bigbearishappy/BBear_balance_car/PCB_MCU/Balance_car_PCB_v4.0_summary.txt

第三版PCB存在的问题：
1 红外遥控接收管的引脚接错
2 电机升压芯片驱动能力不够，需要更换芯片
3 电池接口容易插反
4 没有引出拓展接口
5 串口的vcc脚电压太高了，改为3.3v

第四版需要改进的地方：
1 红外遥控接收管引脚接对 OK
2 去除MCU板上的升压电路 OK
3 将串口的vcc修改为3.3v OK
4 贴片排针注意修改好相关引线 OK
5 给红外接收器加上拉电阻 OK
