bigbearishappy/BBear_balance_car/PCB_MCU/Balance_car_PCB_v2.0_summary.txt

对于上一版问题的解决：
1 对于电阻值的选择没有确定好 OK
2 电机驱动设计前没有验证 OK
3 尽可能采用驱动芯片 OK
4 LED放置位置有问题 OK

第二版存在的问题：
1 电源正负极标反
2 电机驱动模块的定位不准
3 电机放置的位置没有画出来
4 没有总开关

下一版需要修改的地方：
1 电源正负极标对 OK
2 电机驱动模块定位修改好 OK
3 电机放置位置丝印 OK
4 添加总开关  OK
5 蓝牙模块放置于板子中部 OK
6 复位开关换位贴片的  OK
7 boot1,2去掉没有用的那个(去掉boot1,直接接地) OK
8 电机放置时位置往外移动2mm not OK
