bigbearishappy/BBear_balance_car/PCB_MCU/Balance_car_PCB_v1.0_summary.txt

1 对于电阻值的选择没有确定好
2 电机驱动设计前没有验证
3 尽可能采用驱动芯片
4 LED放置位置有问题
