bigbearishappy/BBear_balance_car/PCB_MCU/Balance_car_PCB_v5.0_summary.txt

第四版存在的问题：
1 MPU6050固定效果不好
2 升压电路没有受到总开关控制
3 红外接收器容易接触不良
4 电源拓展接口太少

第五版需要改进的地方：
1 给MPU6050添加铜立柱进行固定 OK
2 升压电路必须收总开关控制 OK
3 红外接收器接口换新接口 OK
4 添加两个3.3v拓展接口及两个GND接口 OK
