bigbearishappy/BBear_balance_car/doc/car_picture/BBear_balancecar1.jpg

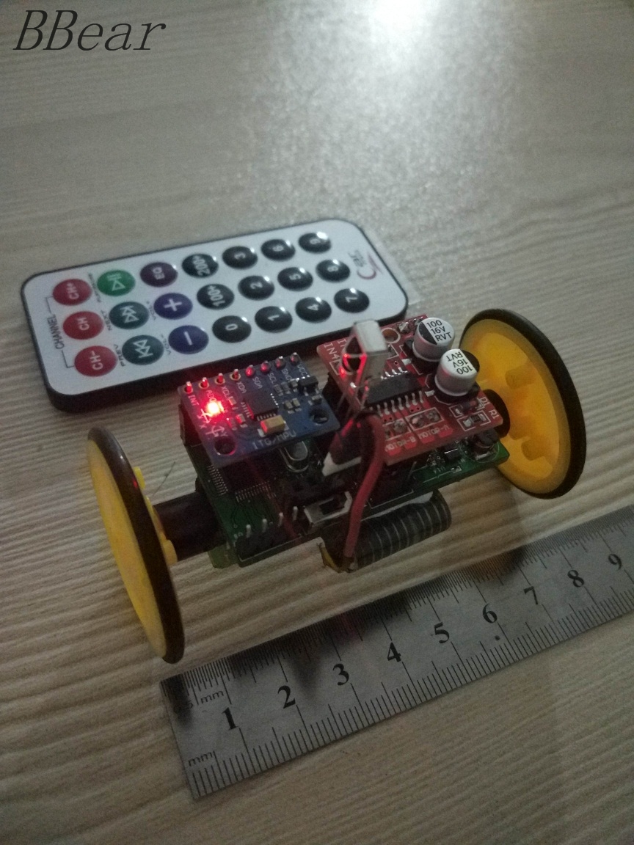
doc/car_picture/BBear_balancecar1.jpg
