bigbearishappy/BBear_balance_car/doc/car_picture/BBear_balancecar4.jpg

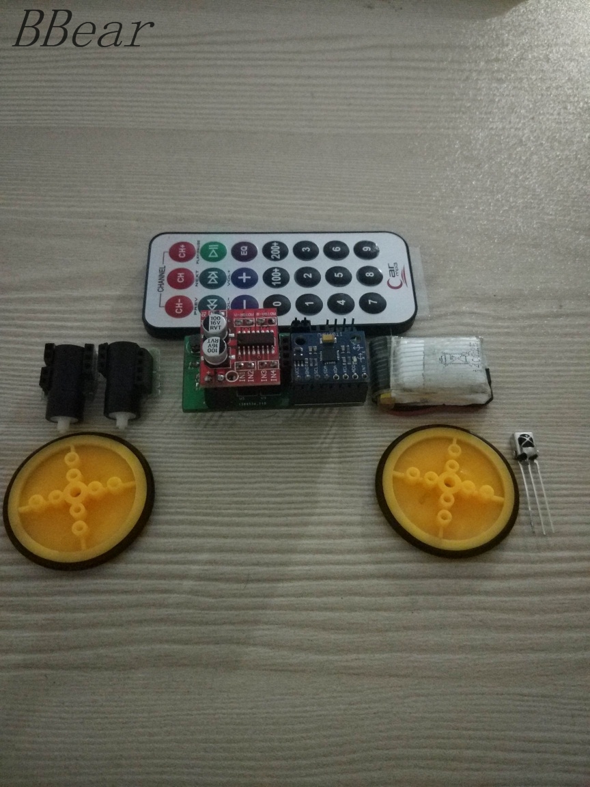
doc/car_picture/BBear_balancecar4.jpg
