bigbearishappy/BBear_balance_car/doc/car_picture/BBear_balancecar7.jpg

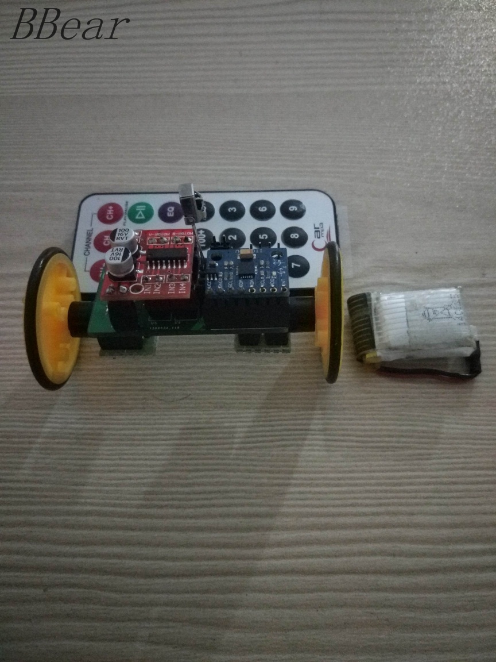
doc/car_picture/BBear_balancecar7.jpg
