bigbearishappy/BBear_balance_car/doc/experience/xtal_unusual_pic.jpg

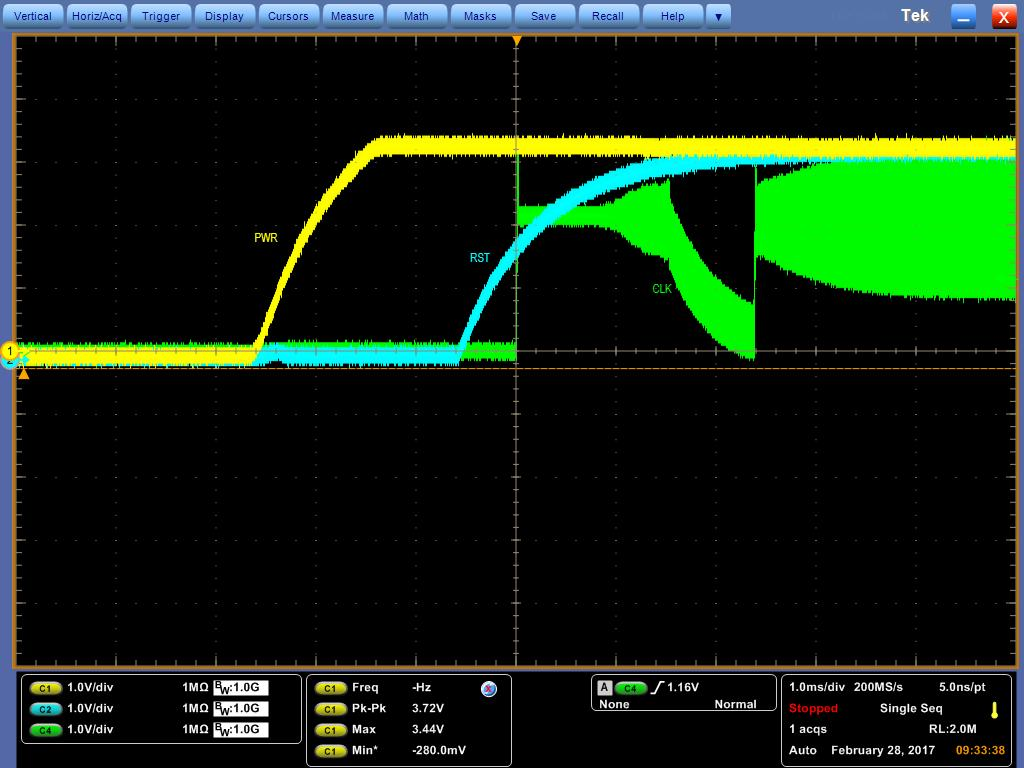
doc/experience/xtal_unusual_pic.jpg
