bigbearishappy/BBear_balance_car/doc/experience/xtal_usual_pic.jpg

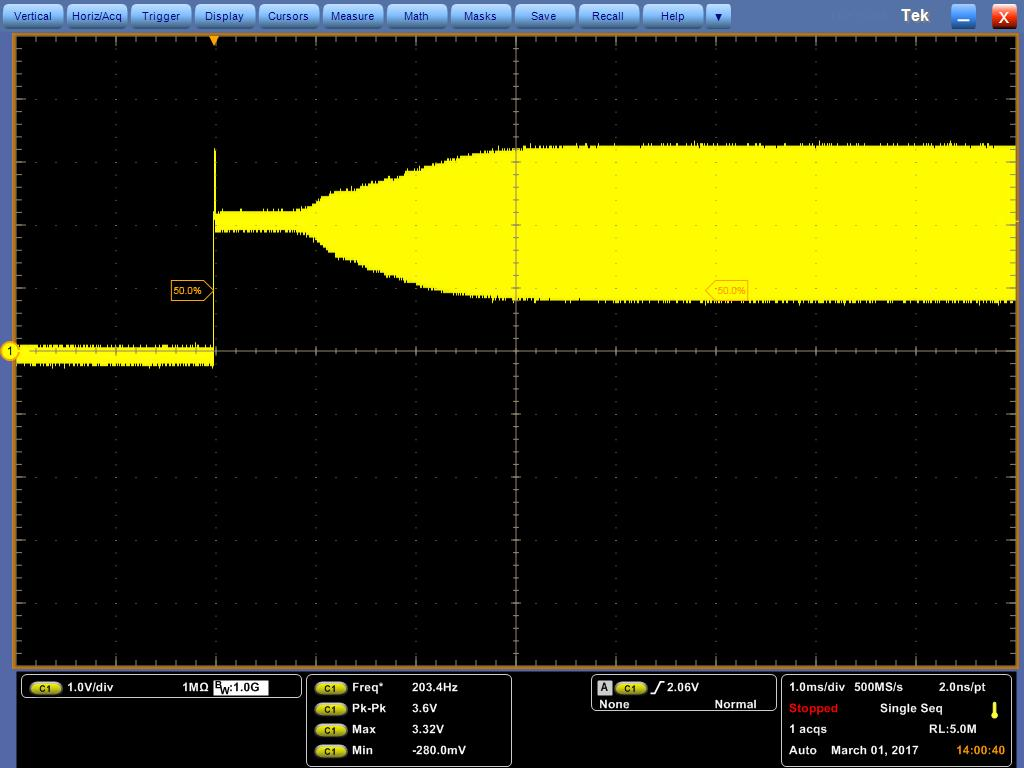
doc/experience/xtal_usual_pic.jpg
