bigbearishappy/BBear_balance_car/PCB_MCU/schematic/8cb1cb13495409232dfafa0c9758d109b3de4935.jpg

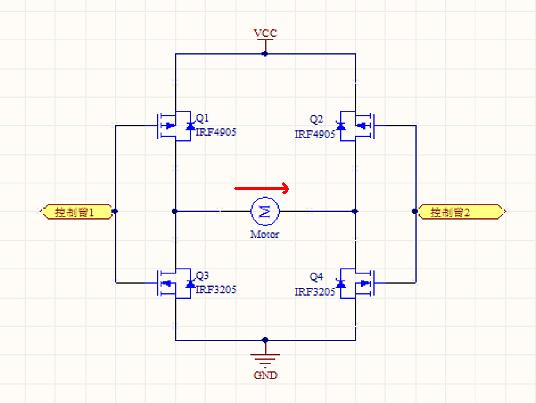
PCB_MCU/schematic/8cb1cb13495409232dfafa0c9758d109b3de4935.jpg
