bigbearishappy/BBear_balance_car/PCB_SPEED/doc/refered_schematic.PNG

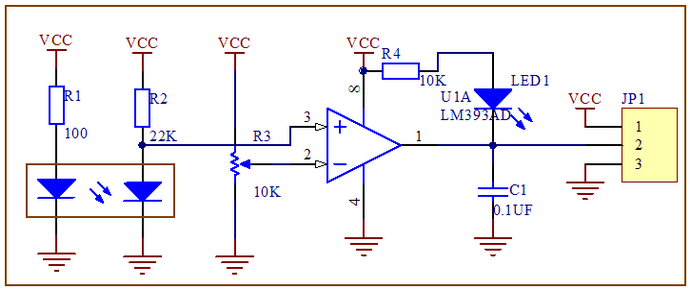
PCB_SPEED/doc/refered_schematic.PNG
