bigbearishappy/BBear_balance_car/(list of files, cad)

Other CAD files:
PCB_MCU/pcb_lib/3_6key.psm
PCB_MCU/pcb_lib/button_6x6x5.psm
PCB_MCU/pcb_lib/c-0603.psm
PCB_MCU/pcb_lib/cd43.psm
PCB_MCU/pcb_lib/con2_r2_54.psm
PCB_MCU/pcb_lib/con3.psm
PCB_MCU/pcb_lib/con4.psm
PCB_MCU/pcb_lib/con8.psm
PCB_MCU/pcb_lib/lm1117_3_3.psm
PCB_MCU/pcb_lib/ncu100_lqfp_48.psm
PCB_MCU/pcb_lib/p4_003_20.psm
PCB_MCU/pcb_lib/sod-123.psm
PCB_MCU/pcb_lib/sot-89.psm
PCB_MCU/pcb_lib/sot223.psm
PCB_MCU/pcb_lib/tp2_54_5.psm
PCB_MCU/pcb_lib/xc9119.psm
PCB_MCU/pcb_lib/xtal.psm
PCB_MOTOR/PCB_lib/1n5819.psm
PCB_MOTOR/PCB_lib/c-0805.psm
PCB_MOTOR/PCB_lib/cdrh104r.psm
PCB_MOTOR/PCB_lib/con5.psm
PCB_MOTOR/PCB_lib/sdb628.psm
PCB_SPEED/pcb_lib/con2_3mm.psm
PCB_SPEED/pcb_lib/con2_3mm_t.psm
PCB_SPEED/pcb_lib/so8.psm
