bigbearishappy/BBear_balance_car/PCB_MCU/bbear_balance_car.pdf

5

4

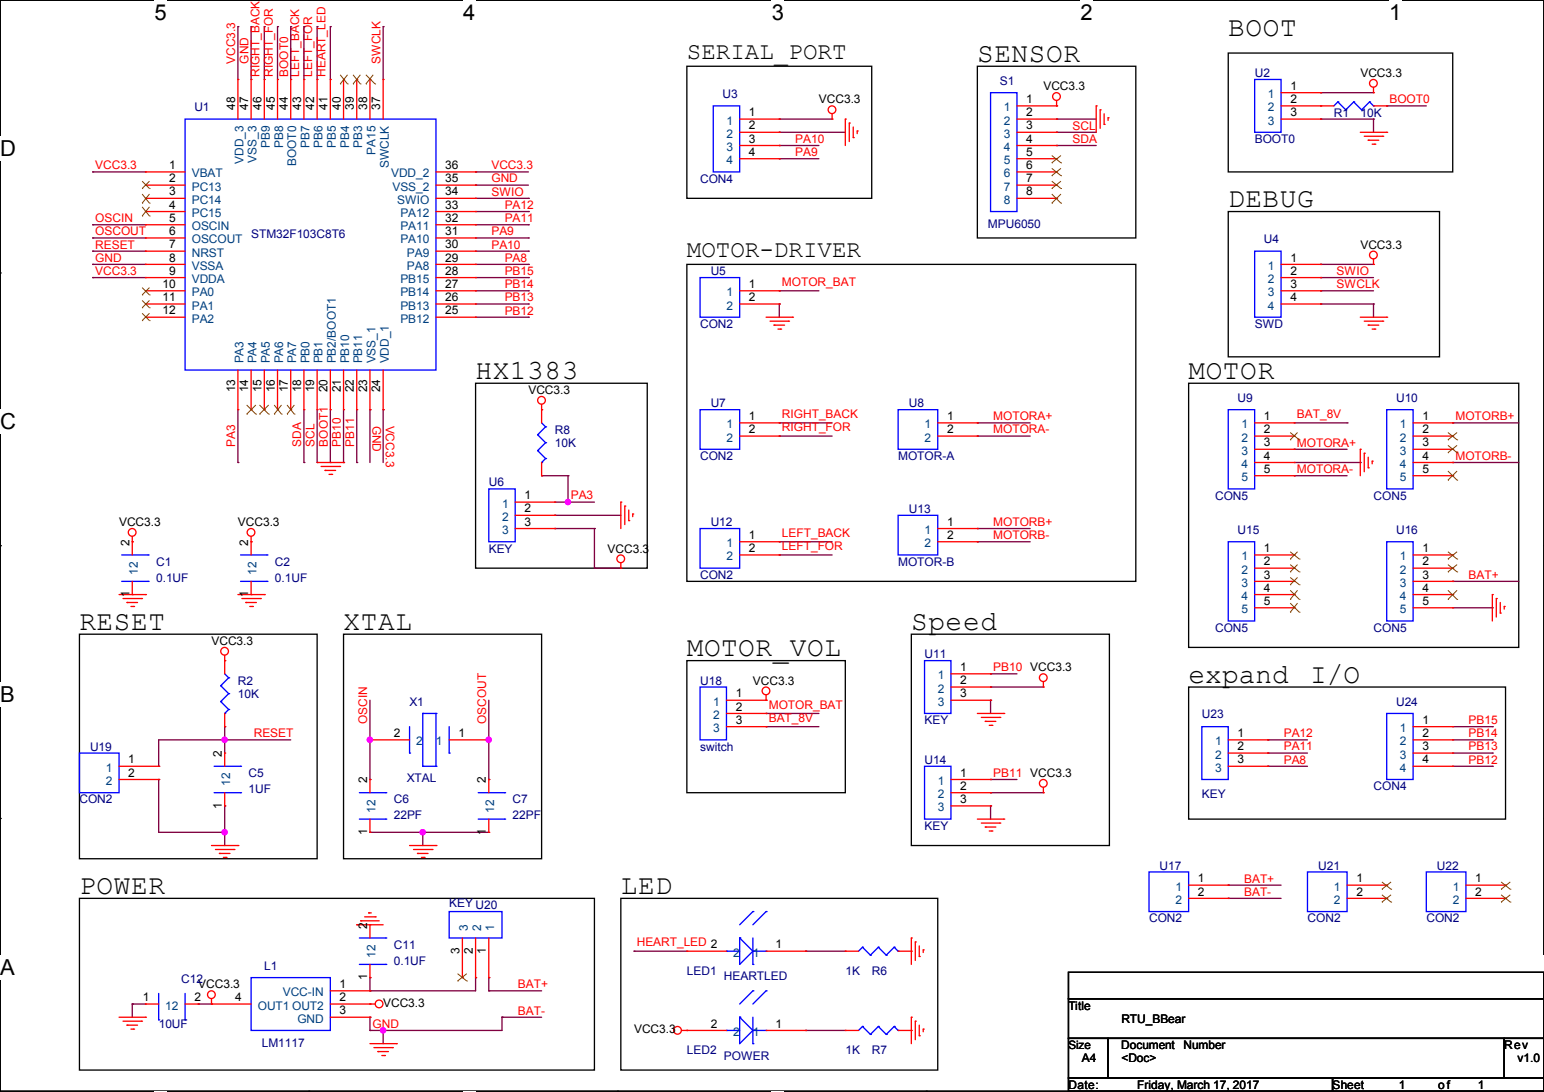
[picture p26: page 1]
