bigbearishappy/BBear_balance_car/PCB_MOTOR/bbear_balance_car_motor.pdf

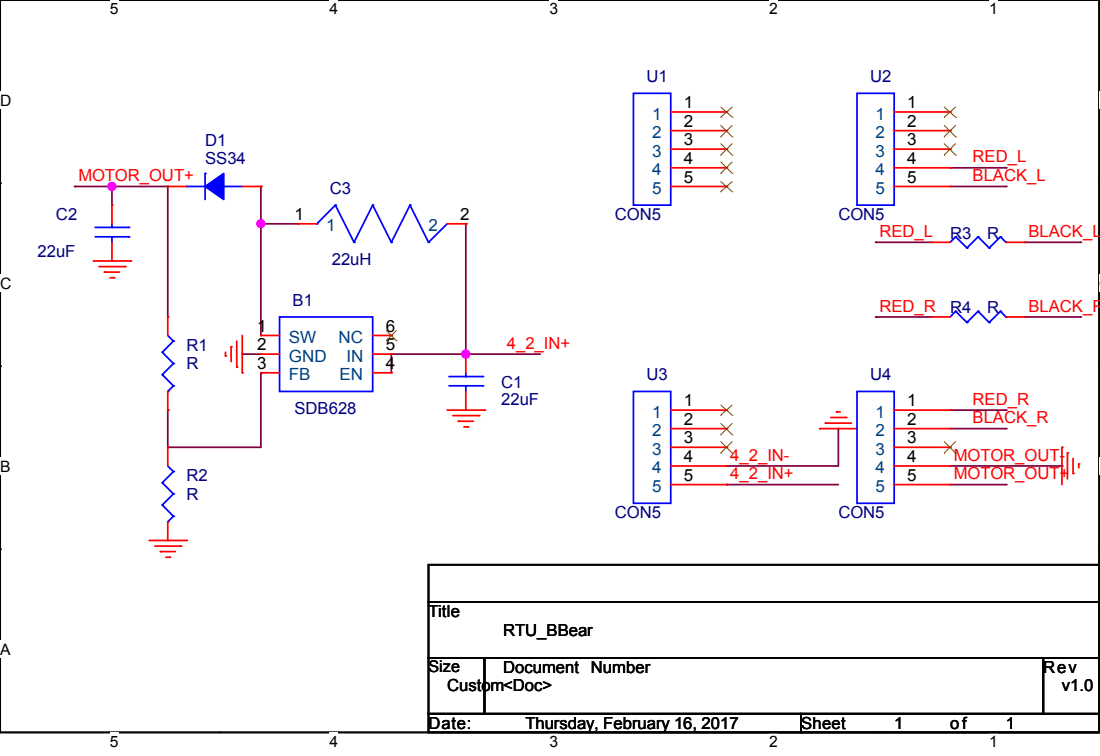
[picture p27: page 1]
