bigbearishappy/BBear_balance_car/(list of files, drawings)

Other design files:
PCB_MCU/schematic/BBEAR_BALANCE_CAR.DSN
PCB_MCU/schematic/BBear_balance_car.opj
PCB_MCU/schematic/DESIGN1.DSN
PCB_MCU/schematic/Design1.opj
PCB_MCU/schematic/f1.opj
PCB_MCU/schematic_lib/LIBRARY1.OLB
PCB_MCU/schematic_lib/library1.opj
PCB_MOTOR/schematic/BBEAR_BALANCE_CAR_MOTOR.DSN
PCB_MOTOR/schematic/BBear_balance_car_motor.opj
PCB_MOTOR/schematic_lib/LIBRARY1.OLB
PCB_MOTOR/schematic_lib/library1.opj
PCB_SPEED/schematic/SPEED_SENSOR.DSN
PCB_SPEED/schematic/Speed_sensor.opj
