bigbearishappy/BBear_balance_car/sourcecode/source_code/APP/pid.h

#ifndef PID_H
#define PID_H
#include<stdint.h>
#include"printf.h"
//#include "BSP.H"

#define LEFT_WHEEL	0x4c//'L' 's ascii code is 0x4c
#define RIGHT_WHEEL	0x52//'R' 's ascii code is 0x52

#define ADD_VALUE_LR	0.3
#define ADD_VALUE_FB	0.05//1

typedef struct PID
{
	float target;
	float integral;
	float Kp;	// 比例系数
	float Ki;	// 积分系数
	float Kd;	// 微分系数/Derivative
}pid_s, *pid_t;

void PID_Init(pid_t pid, float Kp, float Ki, float Kd);
int32_t PID_Cal_Ang(pid_s *p, float current, float differential, int target);
int32_t PID_Cal_Speed(pid_s *p, int32_t current, int32_t target,unsigned char which_wheel);

#endif
