bigbearishappy/BBear_balance_car/(commit log)

2016-10-05 create the catalog of the whole project doc:all the document of the project PCB:all the document of the PCB work source_code:all the source code of the project
2016-10-05 add the catalog of PCB
2016-10-05 create the schematic of project
    [BBEAR_BALANCE_CAR.DSN, BBear_balance_car.opj, DESIGN1.DSN, Design1.opj, LIBRARY1.OLB, f1.opj]
2016-10-06 draw the schematic library
    [BBear_balance_car.opj, LIBRARY1.OLB]
2016-10-07 draw the schematic and the PCB library files
    [BBEAR_BALANCE_CAR.DSN, BBear_balance_car.opj, LIBRARY1.OLB, button_6x6x5.psm, c-0603.psm, c-0805.psm, cases.cfg, con2_r2_54.psm]
2016-10-11 work out the netlist and import it into the board files
    [BBEAR_BALANCE_CAR.DSN, BBear_balance_car.brd, BBear_balance_car.opj, LIBRARY1.OLB, sot223.psm]
2016-10-12 work out the PCB layout
    [BBEAR_BALANCE_CAR.DSN, BBear_balance_car.brd, BBear_balance_car.opj, LIBRARY1.OLB]
2016-10-13 work out the PCB artwork and send it to the factory
    [BBear_balance_car.brd, art_param.txt, cases.cfg, nc_param.txt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]
2016-10-20 add the summary of pcb v1.0
    [BBear_balance_car.brd, BBear_balance_car.opj, Design1.opj]
2016-10-29 add the PCB v2.0 summary
    [BBEAR_BALANCE_CAR.DSN, BBear_balance_car.opj, BBear_balance_carv2_0.brd, art_param.txt, cases.cfg, nc_param.txt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]
2016-11-22 add the XC9119D10AMR circuit design modified the Balance_car_PCB_v2.9_summary.txt
    [BBEAR_BALANCE_CAR.DSN, BBear_balance_car.opj, LIBRARY1.OLB]
2016-11-23 draw the version 3.0 pcb of balance car Signed-off-by: bigbearishappy <953308023@qq.com>
    [BBEAR_BALANCE_CAR.DSN, BBear_balance_car.opj, BBear_balance_carv2_0.brd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]
2016-12-08 pcb version 3.0 update
    [3_6key.psm, BBEAR_BALANCE_CAR.DSN, BBear_balance_car.opj, art_param.txt, cd43.psm, nc_param.txt, sod-123.psm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]
2016-12-24 commit the different files
    [BBear_balance_car.opj]
2017-01-09 draw the 4th pcb
    [BBEAR_BALANCE_CAR.DSN, BBear_balance_car.opj, BBear_balance_carv2_0.brd, art_param.txt, cases.cfg, nc_param.txt, p4_003_20.psm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]
2017-01-18 add the speed control of the car
    [BBear_balance_car.opj]
2017-02-06 add the version 4.0's picture
    [BBear_balance_car.opj]
2017-02-07 debug the speed PID value
2017-02-08 update the speed loop control PID value of the car
2017-02-13 add the PCB v4.0 summary
2017-02-13 add the PCB v5.0 project files
    [BBear_balance_carv2_0.brd, art_param.txt, cases.cfg, nc_param.txt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]
2017-02-13 change the dir name of PCB
    [3_6key.psm, BBEAR_BALANCE_CAR.DSN, BBear_balance_car.brd, BBear_balance_car.opj, BBear_balance_carv2_0.brd, DESIGN1.DSN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]
2017-02-13 draw the motor driver schematic
    [BBEAR_BALANCE_CAR_MOTOR.DSN, BBear_balance_car_motor.opj, LIBRARY1.OLB, library1.opj]
2017-02-14 draw the MCU PCB v5.0 of the car
    [BBEAR_BALANCE_CAR.DSN, BBear_balance_car.opj, BBear_balance_carv2_0.brd, art_param.txt, nc_param.txt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]
2017-02-16 finish the v5.0 of the car PCB, and finish the new motor PCB
    [1n5819.psm, BBEAR_BALANCE_CAR.DSN, BBEAR_BALANCE_CAR_MOTOR.DSN, BBear_balance_car.opj, BBear_balance_car_motor.opj, BBear_balance_carv2_0.brd, art_param.txt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]
2017-02-16 debug the PID value of new motor voltage
2017-02-18 make the right file of MOTOR which will be send to the PCB factory
    [art_param.txt, bbear_balance_car_motor.brd, nc_param.txt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]
2017-02-19 debug the speed control PID of the car
2017-02-20 add the tools which is used to download the hex to stm32 through usart
2017-02-22 add the bom of motor PCB
    [BBear_balance_car.opj, BBear_balance_car_motor.opj]
2017-02-23 make change to MCU PCB
    [BBear_balance_car.opj, BBear_balance_car_motor.opj]
2017-02-27 update the readme.md and upload 3 new picture of the car
    [BBEAR_BALANCE_CAR.DSN, BBear_balance_car.opj, BBear_balance_carv2_0.brd, art_param.txt, nc_param.txt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]
2017-03-03 add a experience of the stm32's oscillator
2017-03-17 debug the offset of mpu6050 data and add the PCB schematic
    [BBEAR_BALANCE_CAR.DSN, BBear_balance_car.opj]
2017-03-20 nomal commit
    [BBear_balance_car.opj, BBear_balance_car_motor.opj]
2017-03-21 comment some printf code
2017-03-25 add the smt files of the MCU PCB
    [BBear_balan_car_SMT_Bom.csv, BBear_balan_car_SMT_Coordinate.csv, BBear_balance_car.opj, BBear_balance_carv2_0.brd, place.csv, place.xlsx, smt_test2.csv, smt_test2.xlsx]
2017-03-26 update the sourcecode
    [BBear_balance_car.opj]
2017-04-04 draw the MCU PCB of version 5.0.For more details,please refer to PCB_MCU/Balance_car_PCB_v5.0_summary.txt
    [BBEAR_BALANCE_CAR.DSN, BBear_balance_car.opj, BBear_balance_carv2_0.brd, art_param.txt, cases.cfg, nc_param.txt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]
2017-04-04 change the I2C SDA pin's output mode to avoid potential problems of I2C ACK
    [i2c.h]
2017-04-13 add the new motor art files
2017-05-14 create the newest pdf of schematic
    [BBear_balance_car.opj, BBear_balance_car_motor.opj]
2017-05-26 add the version 6.0 of mcu pcb
    [BBEAR_BALANCE_CAR.DSN, BBear_balance_car.opj, BBear_balance_carv2_0.brd, Design1.opj, LIBRARY1.OLB, art_param.txt, cases.cfg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]
2017-05-31 draw the flow chart of the sourcecode
2017-09-12 update the test code of new speed sensor
2017-09-24 debug the new speed sensor
2017-10-12 add the pcb files of SPEED sensor
    [BBEAR_BALANCE_CAR.DSN, BBear_balance_car.opj, BBear_speed_sensor.brd, LIBRARY1.OLB, SPEED_SENSOR.DSN, Speed_sensor.opj, art_param.txt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]
2017-10-19 debug the new speed sensor to work properly
    [Speed_sensor.opj]
2017-10-26 debug the problem between the motion control and remote control
    [BSP.C, BSP.H, main.c, pid.c, pwm.c]
2017-11-26 add the bom of smt
    [BBear_balance_speed_SMT_Bom.csv, BBear_balance_speed_SMT_Coordinate.csv]
2018-06-14 update the new pcb file for speed sensor
2018-06-25 add the soft timer for car
